harkiret01/co2-smart-window/docs/images/demo-thumbnail.jpg

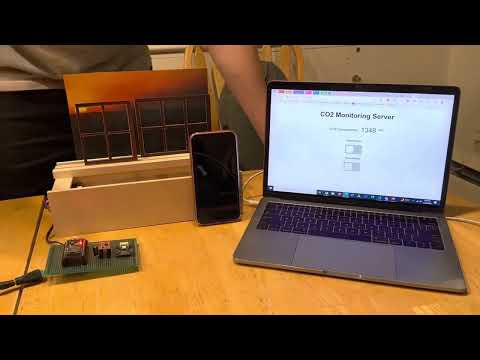
docs/images/demo-thumbnail.jpg
